eliaskoschke/Der-Geraet/Modelle/BeschriftungsPlatten/Schriftenplatte_Seitlich_1.stl

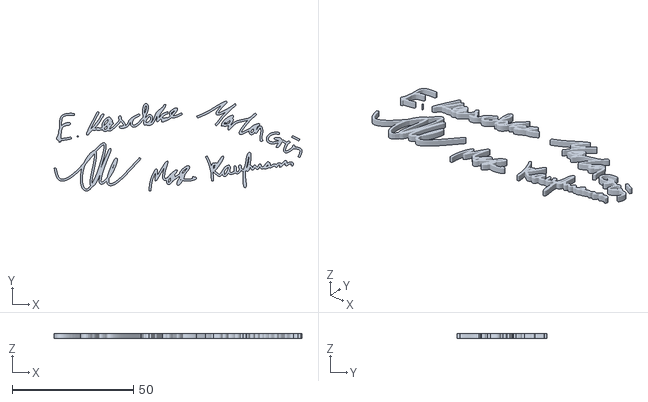
[picture p1: CAD file, 2025-03-31]
Modelle/BeschriftungsPlatten/Schriftenplatte_Seitlich_1.stl
102.1 x 37.2 x 2.00
