eliaskoschke/Der-Geraet/Modelle/MotorRadAdapter.FCStd

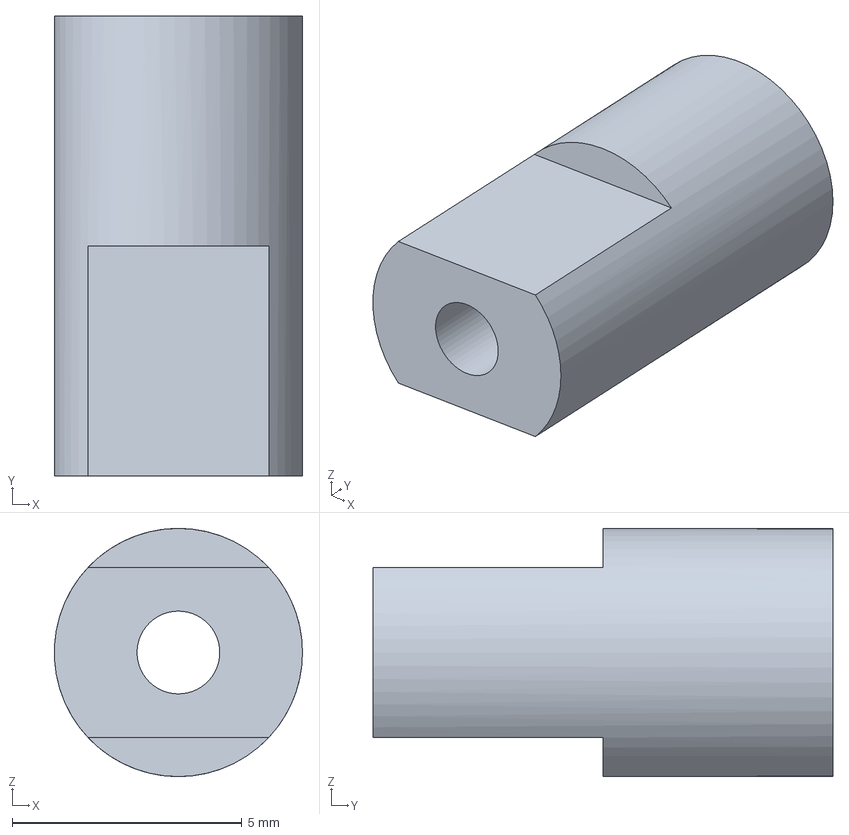
[picture p2: CAD file, 2025-03-31]
Modelle/MotorRadAdapter.FCStd
5.40 x 10.0 x 5.40 mm
