eliaskoschke/Der-Geraet/Modelle/STL/Gehause-Körper.stl

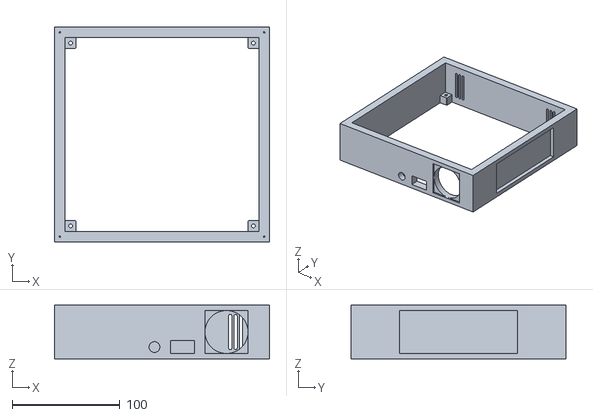
[picture p3: CAD file, 2025-03-31]
Modelle/STL/Gehause-Körper.stl
200.0 x 200.0 x 50.0
