eliaskoschke/Der-Geraet/Modelle/BeschriftungsPlatten/Schriftenplatte_Seitlich_2.stl

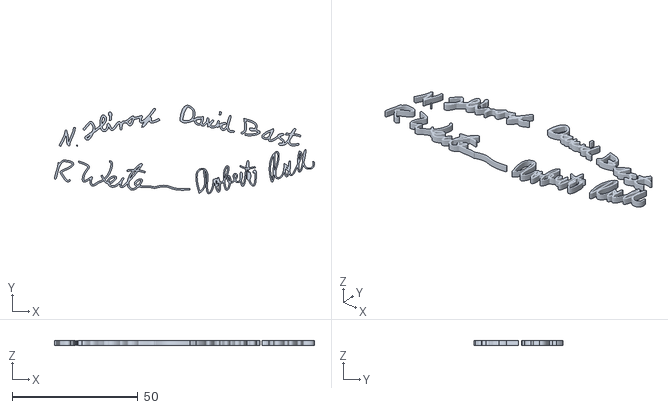
[picture p4: CAD file, 2025-03-31]
Modelle/BeschriftungsPlatten/Schriftenplatte_Seitlich_2.stl
103.3 x 35.2 x 2.00
