eliaskoschke/Der-Geraet/Modelle/Motor-Befestigung-Schraubebefestigung-DerGeraet.FCStd

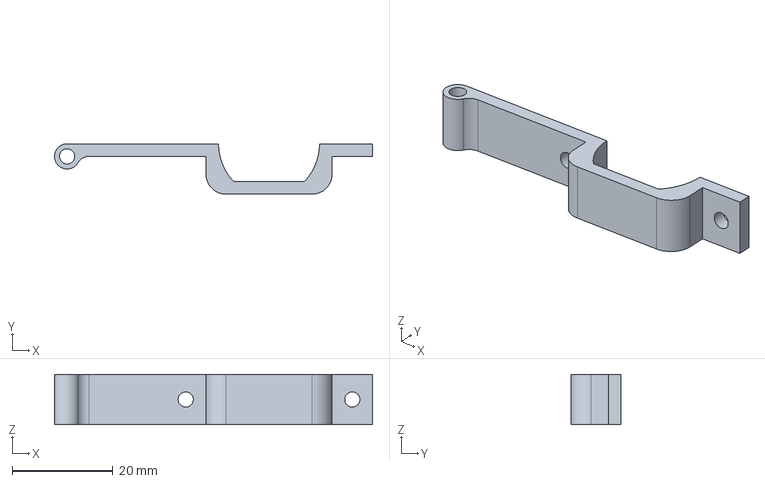
[picture p5: CAD file, 2025-03-31]
Modelle/Motor-Befestigung-Schraubebefestigung-DerGeraet.FCStd
63.0 x 10.0 x 10.0 mm
