eliaskoschke/Der-Geraet/Modelle/STL/Motor-Buegel-DerGeraet-Körper.3mf

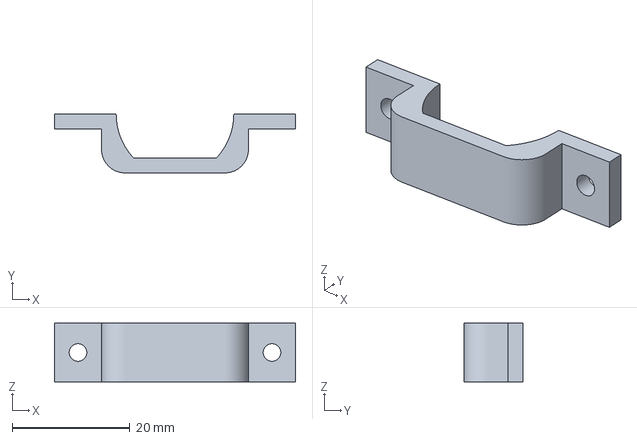
[picture p6: CAD file, 2025-03-31]
Modelle/STL/Motor-Buegel-DerGeraet-Körper.3mf
41.0 x 10.0 x 10.0 mm
