eliaskoschke/Der-Geraet/Modelle/AuswerfRad-DerGeraet.FCStd

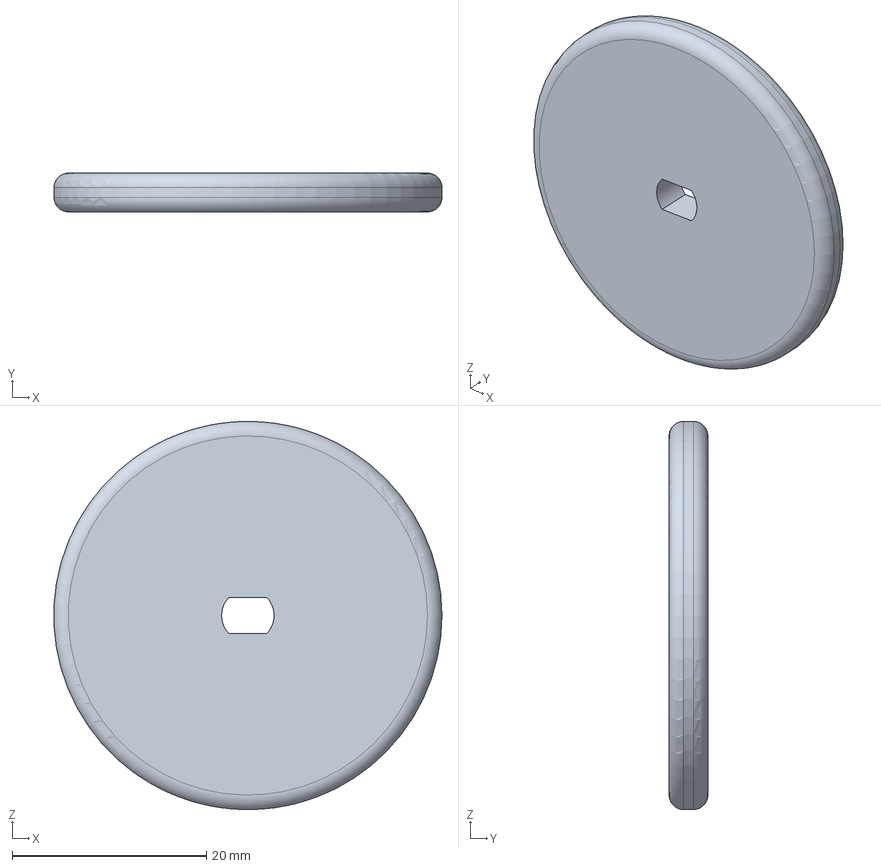
[picture p7: CAD file, 2025-03-31]
Modelle/AuswerfRad-DerGeraet.FCStd
40.0 x 4.00 x 40.0 mm
