eliaskoschke/Der-Geraet/Modelle/BeschriftungsPlatten/Schriftenplatten_STL_verbinden.FCStd

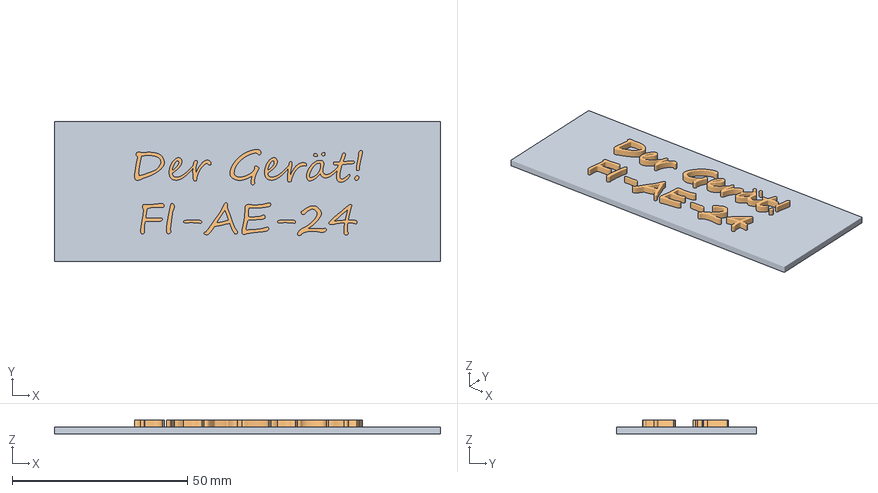
[picture p8: CAD file, 2025-03-31]
Modelle/BeschriftungsPlatten/Schriftenplatten_STL_verbinden.FCStd
110.0 x 40.0 x 3.90 mm
Schriftenplatte_Basis
Schriftenplatte_Frontplatte
