eliaskoschke/Der-Geraet/Modelle/STL/Schriftenplatte_Seitlich_1_mit_Basis.stl

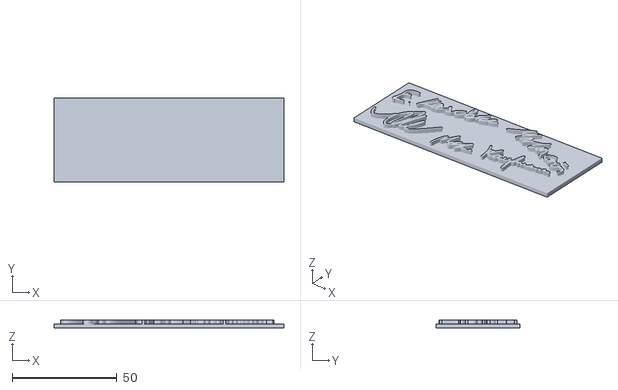
[picture p9: CAD file, 2025-03-31]
Modelle/STL/Schriftenplatte_Seitlich_1_mit_Basis.stl
110.0 x 40.0 x 3.90
