eliaskoschke/Der-Geraet/Modelle/BeschriftungsPlatten/Schriftenplatte_Basis.stl

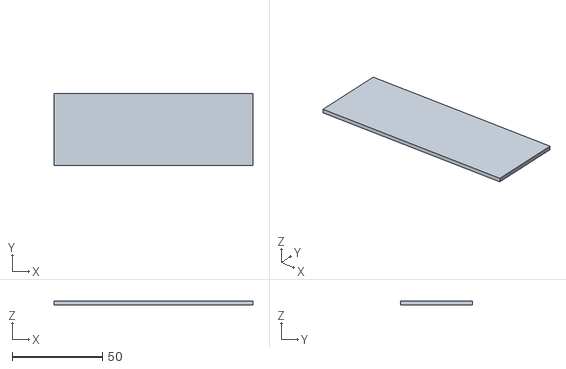
[picture p10: CAD file, 2025-03-31]
Modelle/BeschriftungsPlatten/Schriftenplatte_Basis.stl
110.0 x 40.0 x 2.00
