eliaskoschke/Der-Geraet/Modelle/KeyCap-DerGeraet.FCStd

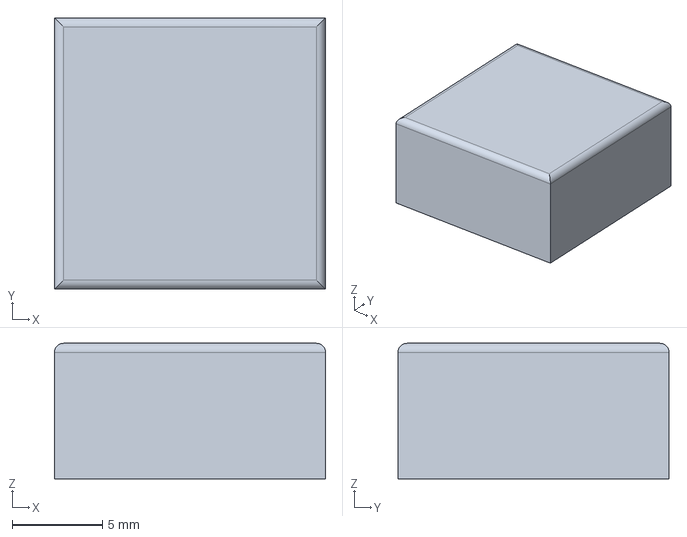
[picture p11: CAD file, 2025-03-31]
Modelle/KeyCap-DerGeraet.FCStd
15.0 x 15.0 x 7.50 mm
