eliaskoschke/Der-Geraet/Modelle/STL/InnenZahnradMitHalterungV5_Grosse_Antrieb.stl

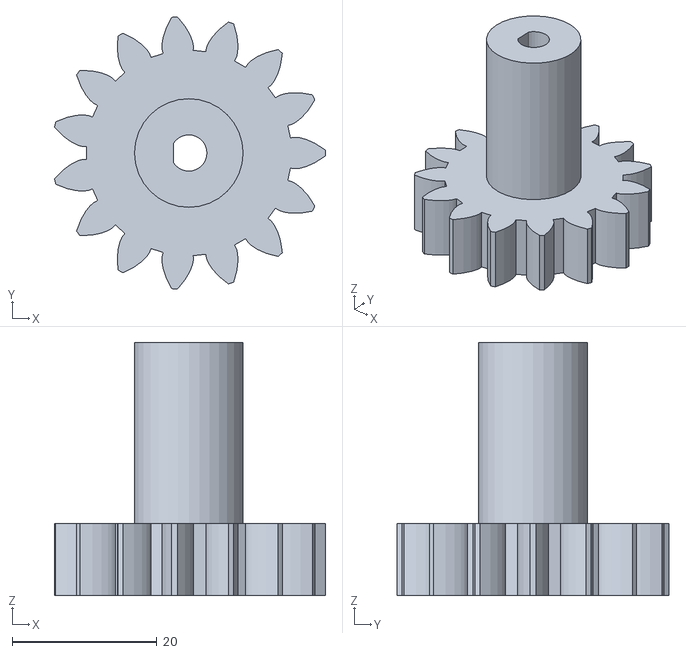
[picture p12: CAD file, 2025-03-31]
Modelle/STL/InnenZahnradMitHalterungV5_Grosse_Antrieb.stl
37.4 x 37.6 x 35.0
