eliaskoschke/Der-Geraet/Modelle/_Zahnrad-vergleich.FCStd

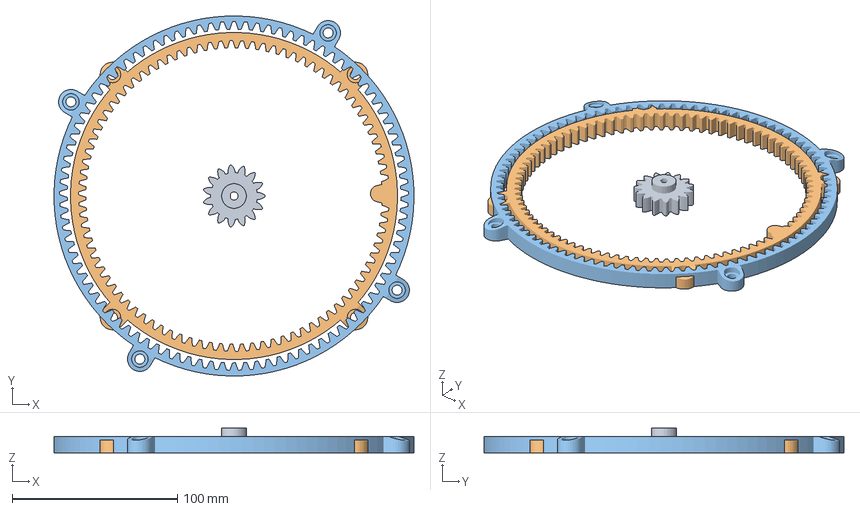
[picture p13: CAD file, 2025-03-31]
Modelle/_Zahnrad-vergleich.FCStd
218.0 x 218.0 x 15.0 mm
InnenZahnradMitHalterungV5_Grosse_Zaehne_Antrieb
InnenZahnradMitHalterungV5_Grosse_Zaehne_Aussen
InnenZahnradMitHalterungV5_Grosse_Zaehne_Aussen001
