eliaskoschke/Der-Geraet/Modelle/Ausweerfmotor-DerGeraet.FCStd

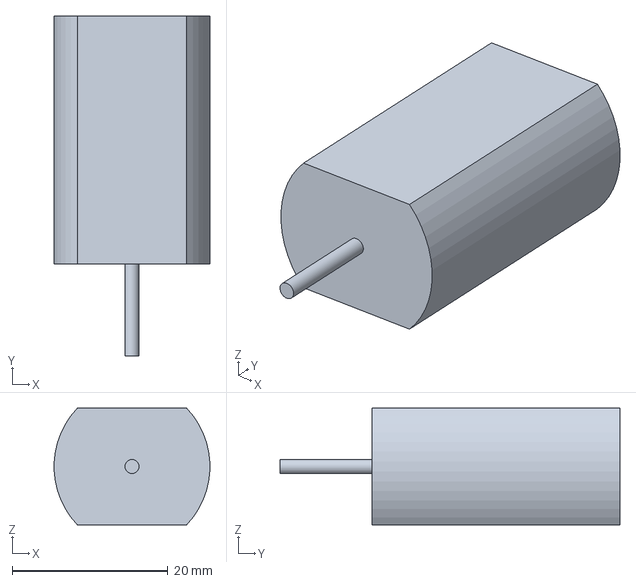
[picture p15: CAD file, 2025-03-31]
Modelle/Ausweerfmotor-DerGeraet.FCStd
20.0 x 43.6 x 15.0 mm
