eliaskoschke/Der-Geraet/Modelle/STL/Geruest-Fuß-links-DerGeraet-Körper.3mf

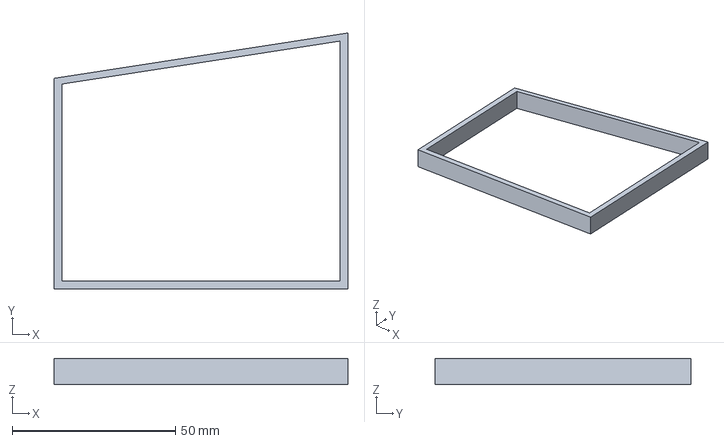
[picture p16: CAD file, 2025-03-31]
Modelle/STL/Geruest-Fuß-links-DerGeraet-Körper.3mf
90.0 x 78.4 x 8.00 mm
