eliaskoschke/Der-Geraet/Modelle/STL/Gerüst-Fuß-Hinten-DerGerät.stl

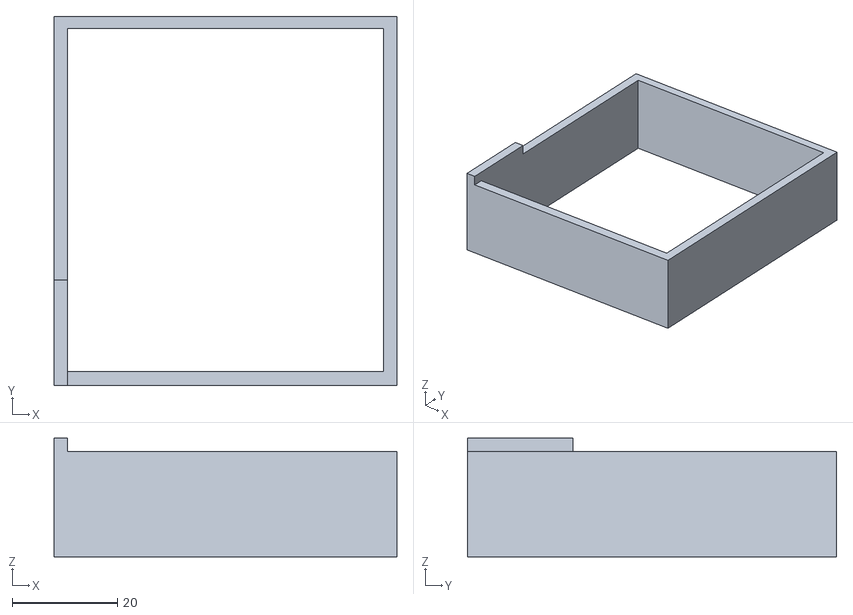
[picture p17: CAD file, 2025-03-31]
Modelle/STL/Gerüst-Fuß-Hinten-DerGerät.stl
65.0 x 70.0 x 22.5
