eliaskoschke/Der-Geraet/Modelle/Geruest-DerGeraet.FCStd

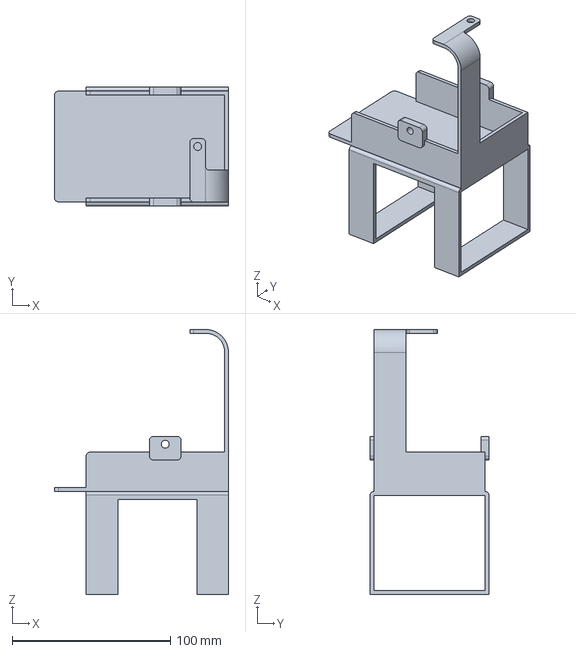
[picture p18: CAD file, 2025-03-31]
Modelle/Geruest-DerGeraet.FCStd
110.0 x 75.0 x 167.5 mm
