eliaskoschke/Der-Geraet/Modelle/STL/Steppermotor-Supportstütze-DerGerät.stl

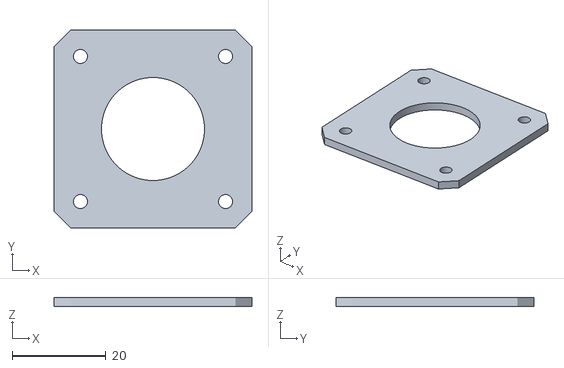
[picture p19: CAD file, 2025-03-31]
Modelle/STL/Steppermotor-Supportstütze-DerGerät.stl
42.3 x 42.3 x 2.00
