eliaskoschke/Der-Geraet/Modelle/Geruest-Fuß-rechts-DerGeraet.FCStd

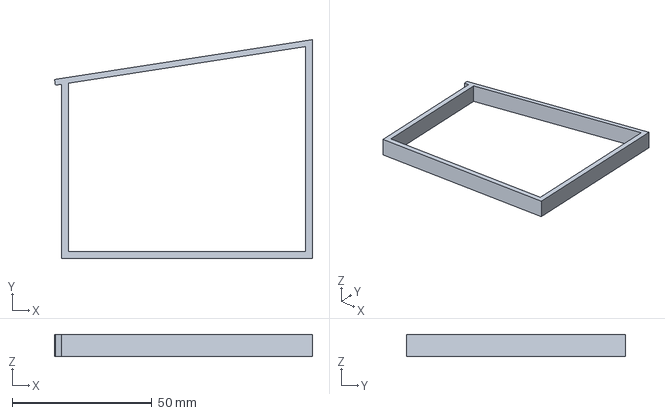
[picture p20: CAD file, 2025-03-31]
Modelle/Geruest-Fuß-rechts-DerGeraet.FCStd
92.5 x 78.4 x 8.00 mm
