eliaskoschke/Der-Geraet/Modelle/STL/Button_03.stl

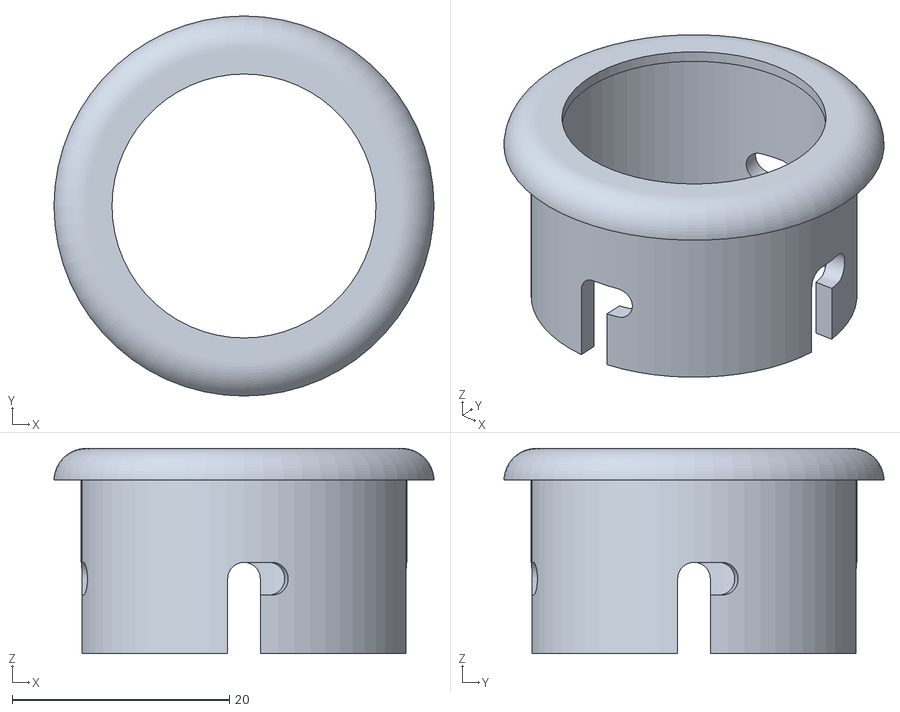
[picture p21: CAD file, 2025-03-31]
Modelle/STL/Button_03.stl
35.0 x 35.0 x 18.9
