eliaskoschke/Der-Geraet/Modelle/Motor-Befestigung-DerGeraet.FCStd

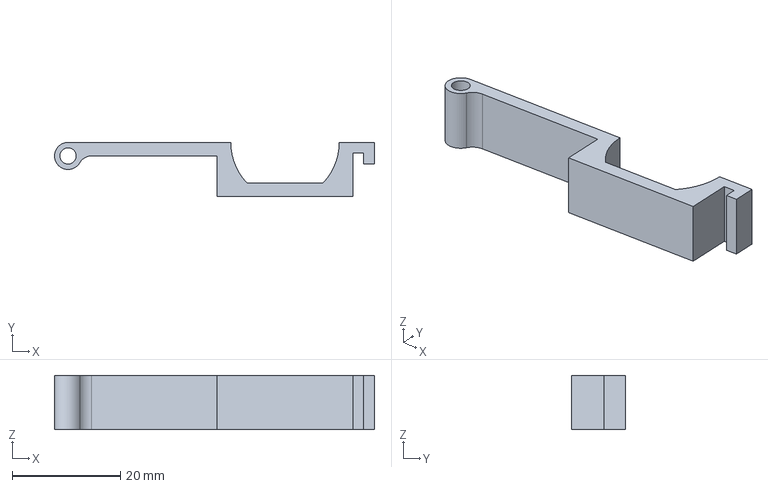
[picture p22: CAD file, 2025-03-31]
Modelle/Motor-Befestigung-DerGeraet.FCStd
59.0 x 10.0 x 10.0 mm
