eliaskoschke/Der-Geraet/Modelle/STL/InnenZahnradMitHalterungV5_Grosse_Zaehne_Aussen.stl

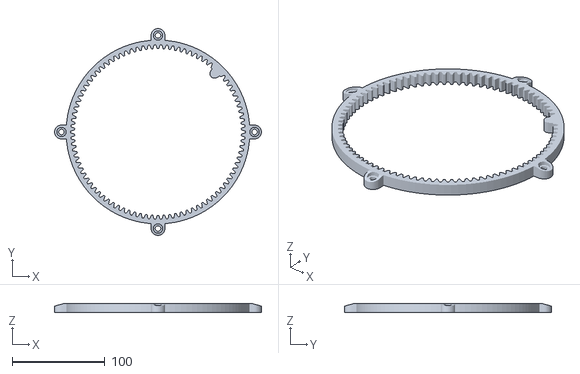
[picture p23: CAD file, 2025-03-31]
Modelle/STL/InnenZahnradMitHalterungV5_Grosse_Zaehne_Aussen.stl
223.0 x 223.0 x 10.0
