eliaskoschke/Der-Geraet/Modelle/Ausweerfmotor-Befestigung.FCStd

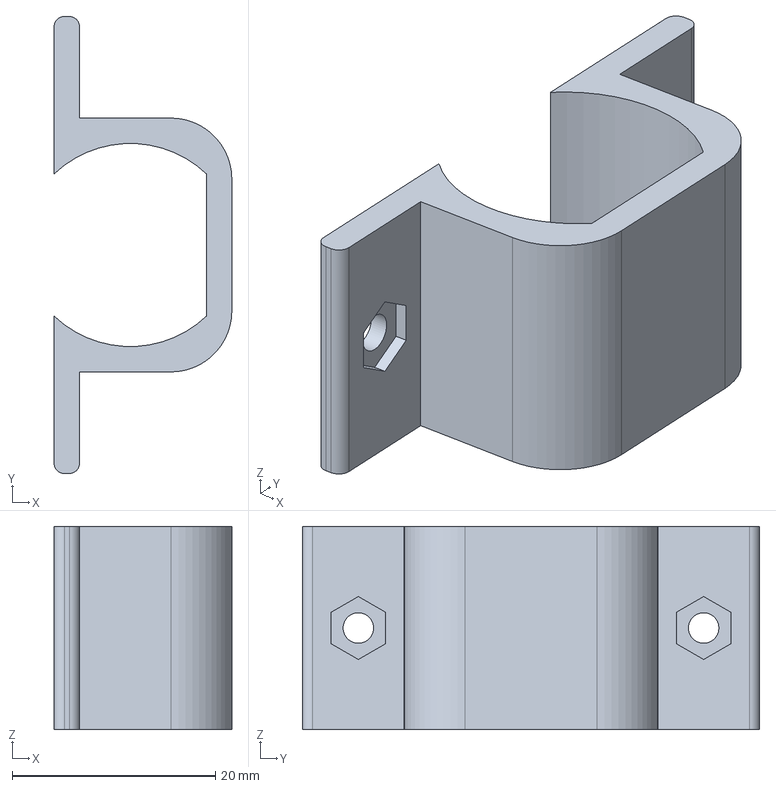
[picture p24: CAD file, 2025-03-31]
Modelle/Ausweerfmotor-Befestigung.FCStd
17.5 x 45.0 x 20.0 mm
