eliaskoschke/Der-Geraet/Modelle/STL/Gerüst-Kartenhalter-DerGerät.stl

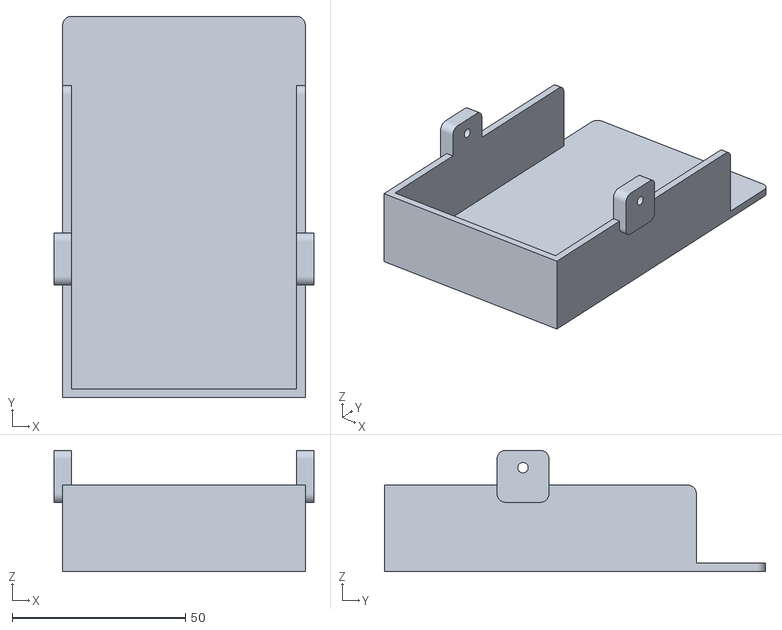
[picture p25: CAD file, 2025-03-31]
Modelle/STL/Gerüst-Kartenhalter-DerGerät.stl
75.0 x 110.0 x 35.0
