eliaskoschke/Der-Geraet/Modelle/Rad-DerGerät.FCStd

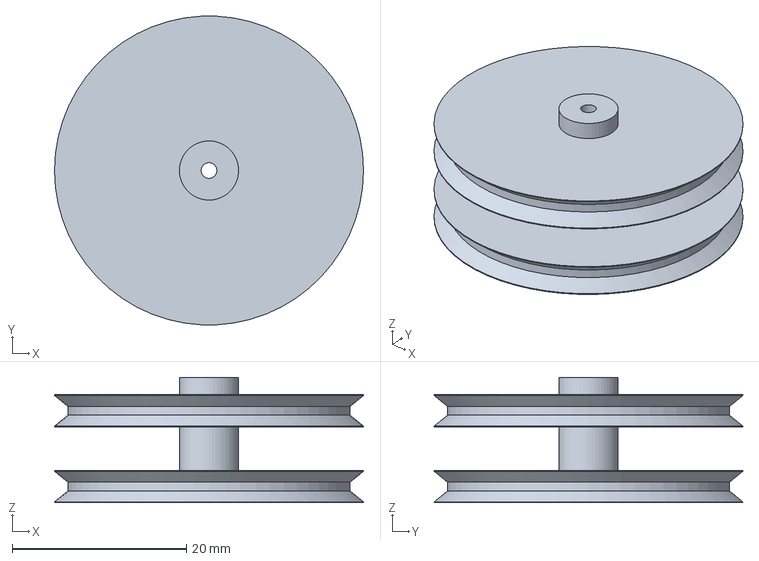
[picture p26: CAD file, 2025-03-31]
Modelle/Rad-DerGerät.FCStd
35.5 x 35.4 x 14.4 mm
