eliaskoschke/Der-Geraet/Modelle/STL/Gerüst-Fuß-Vorne-DerGerät.stl

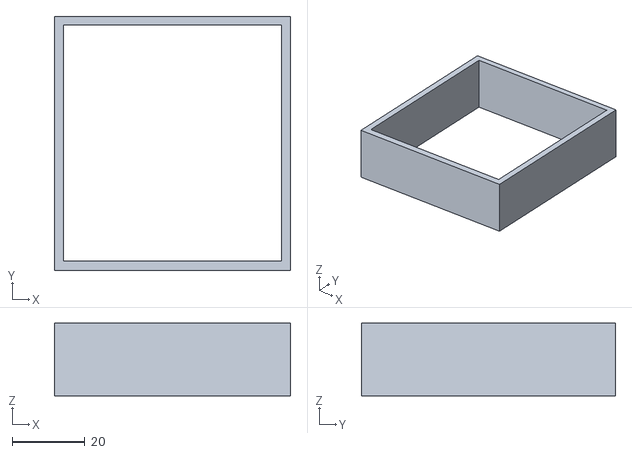
[picture p27: CAD file, 2025-03-31]
Modelle/STL/Gerüst-Fuß-Vorne-DerGerät.stl
65.0 x 70.0 x 20.0
