eliaskoschke/Der-Geraet/Modelle/STL/Gerüst-Kameraständer-DerGerät.stl

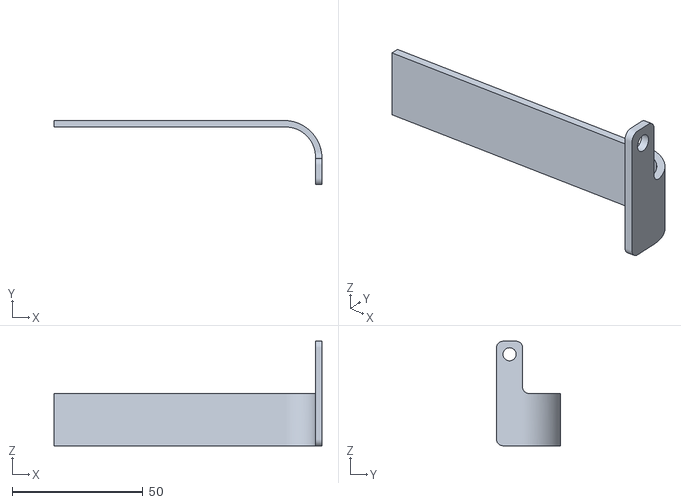
[picture p28: CAD file, 2025-03-31]
Modelle/STL/Gerüst-Kameraständer-DerGerät.stl
102.5 x 24.5 x 40.0
