eliaskoschke/Der-Geraet/Modelle/Geruest-Kameraständer-DerGeraet.FCStd

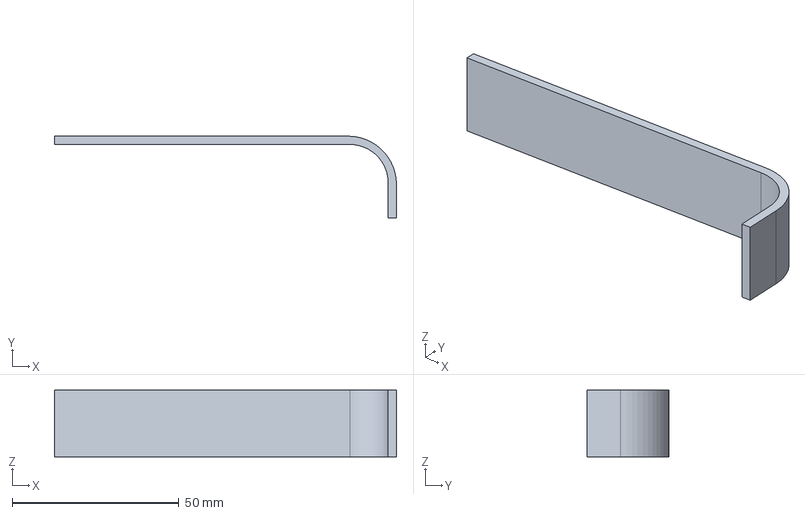
[picture p29: CAD file, 2025-03-31]
Modelle/Geruest-Kameraständer-DerGeraet.FCStd
102.5 x 24.5 x 20.0 mm
