eliaskoschke/Der-Geraet/Modelle/STL/Zahnräder(brauchen_eigentlich_nur_das-Kleine).stl

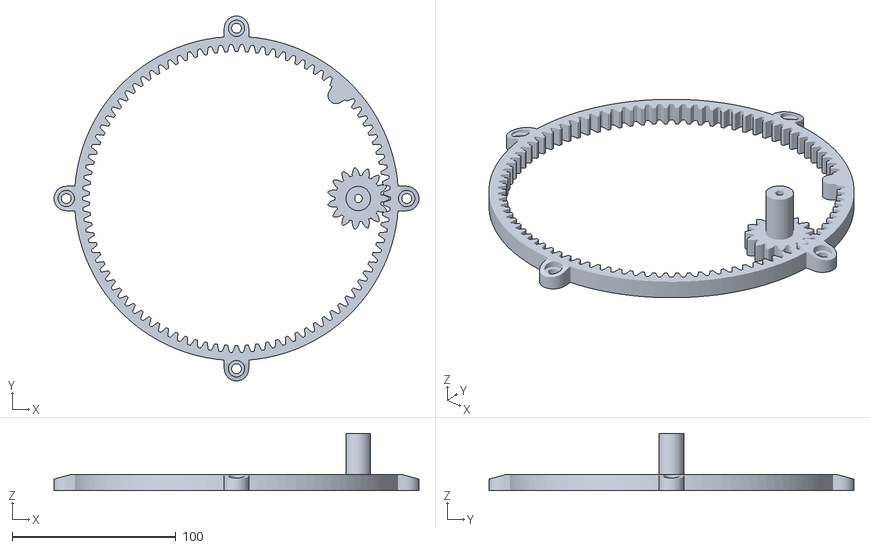
[picture p30: CAD file, 2025-03-31]
Modelle/STL/Zahnräder(brauchen_eigentlich_nur_das-Kleine).stl
223.0 x 223.0 x 35.0
