eliaskoschke/Der-Geraet/Modelle/KameraHalterung-DerGeraet1.FCStd

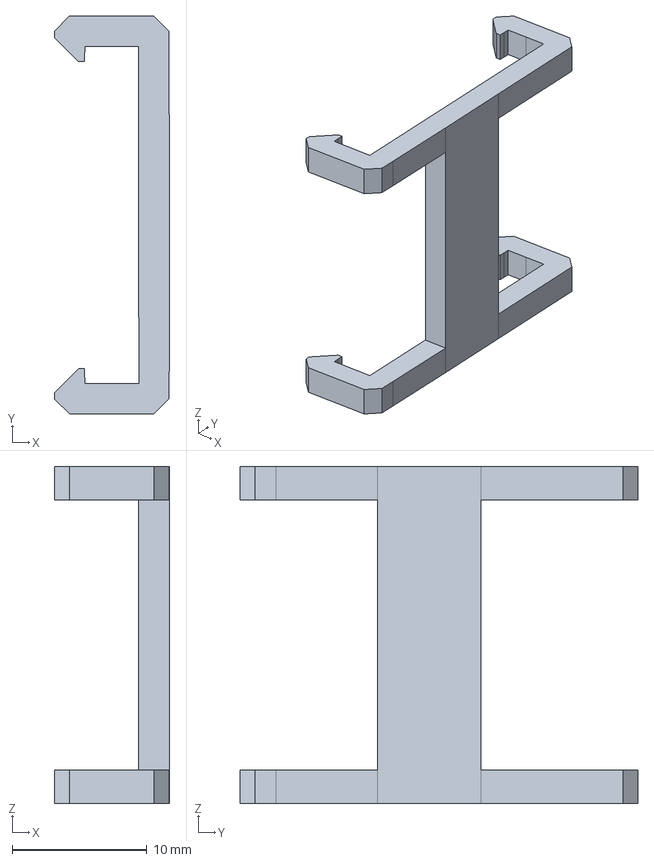
[picture p31: CAD file, 2025-03-31]
Modelle/KameraHalterung-DerGeraet1.FCStd
8.56 x 29.5 x 25.0 mm
