eliaskoschke/Der-Geraet/Modelle/STL/Button_01.stl

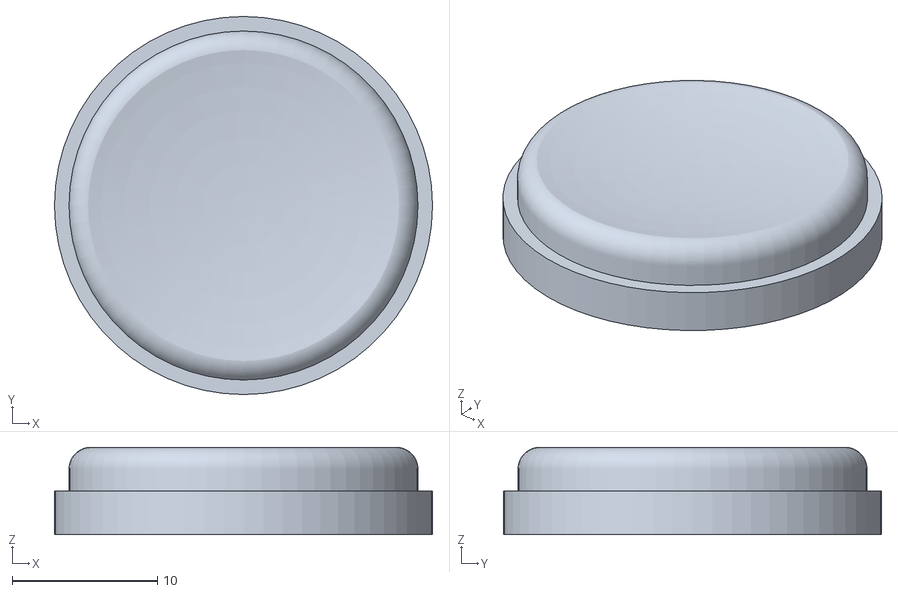
[picture p32: CAD file, 2025-03-31]
Modelle/STL/Button_01.stl
26.0 x 26.0 x 5.99
