eliaskoschke/Der-Geraet/Modelle/Geruest-Kartenhalter-DerGeraet.FCStd

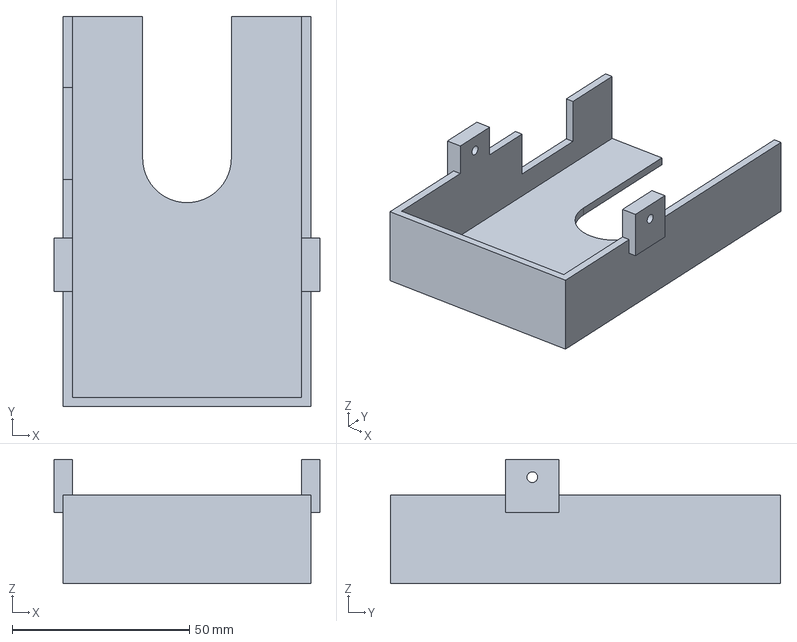
[picture p33: CAD file, 2025-03-31]
Modelle/Geruest-Kartenhalter-DerGeraet.FCStd
75.0 x 110.0 x 35.0 mm
