eliaskoschke/Der-Geraet/Modelle/LuefterGitter.FCStd

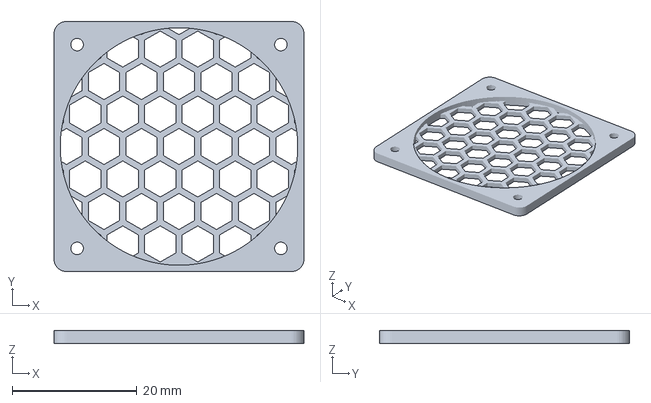
[picture p34: CAD file, 2025-03-31]
Modelle/LuefterGitter.FCStd
40.0 x 40.0 x 2.00 mm
