eliaskoschke/Der-Geraet/Modelle/STL/Button_02.stl

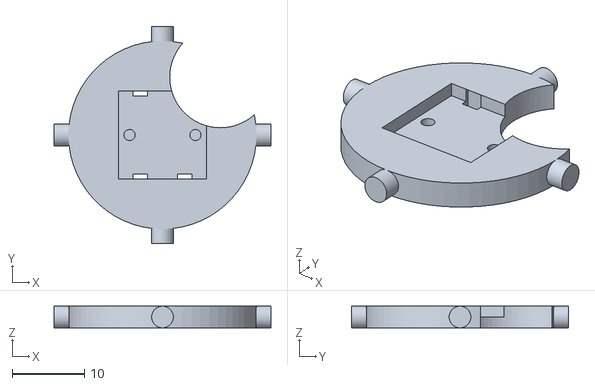
[picture p35: CAD file, 2025-03-31]
Modelle/STL/Button_02.stl
30.0 x 30.0 x 3.00
