eliaskoschke/Der-Geraet/Modelle/STL/MotorStange-DerGerät-Körper.stl

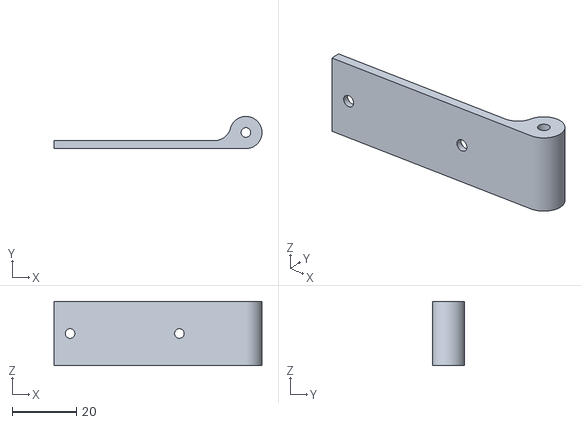
[picture p36: CAD file, 2025-03-31]
Modelle/STL/MotorStange-DerGerät-Körper.stl
64.7 x 10.00 x 20.0
