eliaskoschke/Der-Geraet/(list of files, cad)

Other CAD files:
Modelle/Baugruppe-DerGeraet.FCStd
Modelle/BeschriftungsPlatten/Schriftenplatte_Frontplatte.stl
Modelle/Motor-Buegel-DerGeraet.FCStd
Modelle/Steppermotor-Supportstütze-DerGeraet.FCStd
Modelle/STL/Geruest-Fuß-rechts-DerGeraet-Körper.3mf
Modelle/_GesamtansichtPrototyp.FCStd
Modelle/STL/Motor-Befestigung-Schraubebefestigung-DerGeraet-Körper.3mf
Modelle/Gehause.FCStd
Modelle/STL/Motor-Rad-Adapter-DerGerät.stl
Modelle/Geruest-Fuß-links-DerGeraet.FCStd
Modelle/STL/Ausweerfmotor-DerGeraet-Körper001.3mf
Modelle/STL/Schriftenplatte_Frontplatte_mit_Basis.stl
Modelle/STL/Rad-DerGerät-Körper.stl
Modelle/Rad-DerGeraet.FCStd
Modelle/STL/Geruest-Kameraständer-DerGeraet-Körper.3mf
Modelle/STL/KameraHalterung-DerGerät.stl
Modelle/STL/Geruest-Kartenhalter-DerGeraet-Körper.3mf
Modelle/Archiv/Stange-DerGeraet.FCStd
Modelle/STL/Ausweerfmotor-Befestigung.stl
Modelle/STL/LuefterGitter.stl
