eliaskoschke/Der-Geraet/src/main/java/com/example/tcm2209/StepperController.java

package com.example.tcm2209;

import com.pi4j.context.Context;
import com.example.tcm2209.TMCCommunicationException;
import com.example.tcm2209.TMCDeviceIsBusyException;
import com.example.tcm2209.Tmc2209;

public class StepperController {
    private static final int PIN_INDEX = 23;
    private static final int PIN_STEP = 18;
    private static final int PIN_DIR = 24;
    private static final int SPEED = 1200;
    private static final int HOMESPEED = 1000;
    private static final int TRESHOLD = 58;
    Tmc2209 steppermotor;

    Context pi4j;

    public StepperController(Context pi4j) {
        try {
            this.pi4j = pi4j;
            steppermotor = new Tmc2209(pi4j, PIN_INDEX, PIN_DIR, PIN_STEP);
        } catch( Exception e){
            e.printStackTrace();
        }
    }

    public void orientieren() throws TMCDeviceIsBusyException {
        steppermotor.homePosition(HOMESPEED,TRESHOLD);
    }

    public void turn(int grad) throws TMCDeviceIsBusyException {
        steppermotor.moveToPosition(calc(grad),SPEED);
    }

    /**
     * Rechnung:
     * 8: treiber hat pro Grad des Steppers 8 Schritte
     * 1.8: Grad pro schritt
     * 6: Verhältnis von großem zu kleinem Rad
     * @param grad des Gerätes zu der es soll
     * @return umgerechnte Schritte des Motors
     */
    private int calc(int grad) {
        int result = (int) ((grad * 8) /(1.8 / 6 ));//TODO: Testen ob statt 6 doch 2.6 verwendet werden muss
        return result;
    }
}
