eliaskoschke/Der-Geraet/(commit log)

2025-02-13 Reset Funktion für Rückgabewerte wurde eingefügt
    [Controller.java]
2025-02-19 Button click an Web angepasst, damit es endlich funktioniert
2025-02-19 Test um LED anzusteuern
2025-02-19 Button Klick LED Test hat geklappt
2025-02-19 ButtonClickedTwice wurde hinzugefügt
2025-02-20 Timer zum Bilder testen hinzugefügt
2025-02-20 Discard Motor wurde hinzugefügt
2025-02-20 Motoren pins wurden angepasst
2025-02-20 bilder und leichte aenderungen
2025-02-20 Karten auf der Website werden jetzt auch verdeckt angezeigt
2025-02-21 Kamera per Knopdruck ansteuern ist jetzt möglich und auch, dass es ein Karten Objekt erstellt
2025-02-21 Behebung, dass Karte "wert" ein Integer ist und kein string
2025-02-21 fehler behoben (Controller) Anpassungen website
    [Controller.java]
2025-02-21 Gerüst in einzelteile zerlegt
    [Gerüst-Fuß-Hinten-DerGerät.FCStd, Gerüst-Fuß-Vorne-DerGerät.FCStd, Gerüst-Kameraständer-DerGerät.FCStd, Gerüst-Kartenhalter-DerGerät.FCStd]
2025-02-21 -Bug Fixes -MErge Conflikt Probleme wurden hoffentlich behoben
    [Controller.java, GameService.java, Main.java]
2025-02-24 Regedtrieren der Spieler klappt einigermasen aber mann muss beides ungefähr gleichzeitig starten
2025-02-24 Zahnrad STL Aussen und Antrieb separat
    [InnenZahnradMitHalterungV5_Grosse_Zaehne_Antrieb.stl, InnenZahnradMitHalterungV5_Grosse_Zaehne_Aussen.stl]
2025-02-25 Mapping Klasse für die button und button Freigabe. Button High Un dLow setzen wird jetzt in der RaspberryController Klasse gemacht.
2025-02-27 Docu Getriebe und V5 incl. aktueller STL hochgeladen.
    [InnenZahnradMitHalterungV5_Grosse_Zaehne.stl, InnenZahnradMitHalterungV5_Grosse_Zaehne_Antrieb.stl, InnenZahnradMitHalterungV5_Grosse_Zaehne_Aussen.stl, Zahlräder-DerGerät.scad]
2025-03-04 Einzel und Doppelklick funktionieren
2025-03-04 Lueftergitte ergänzt - Gesamtansicht prototyp
    [LuefterGitter.FCStd, LuefterGitter.stl, MontageTestdie321654316463.FCStd, _GesamtansichtPrototyp.FCStd, _Zahnrad-vergleich.FCStd]
2025-03-04 Lueftergitter flach liegend
    [LuefterGitter.FCStd, LuefterGitter.stl]
2025-03-05 Erster Versuch eines Reset und Restart Buttons
    [GameService.java, Main.java]
2025-03-05 Verstärkungszylinder wurde auf 25mm abgeändert
    [Zahlräder-DerGerät.scad]
2025-03-06 wird eh nicht klappen
2025-03-06 MotorController sind im Main
2025-03-06 Hoffentlich Fixed es das wieder
    [Controller.java, GameService.java, Main.java]
2025-03-07 fehlerbehebung js dass section nicht in der sitzauswahl angezeigt wird
2025-03-07 Stepper Motor Klappt mit Positionen
2025-03-10 Auswurf Motor wurde hinzugefügt
2025-03-13 Website Fix versuch 1
    [Controller.java, Main.java]
2025-03-13 Website Fix versuch 2
    [Controller.java]
2025-03-13 settings-html und admin-html winner eingefügt
2025-03-13 Website Fix versuch 3
    [Controller.java, Main.java]
2025-03-13 Website Fix versuch 4
    [KartenMotor.java, Main.java]
2025-03-13 current player gefixt?
2025-03-13 dealerhand und currentplayer in admin gefixt?
2025-03-13 dealerhand und spieleranzahl gefixt (hoffentlich)
2025-03-13 ping und admin.html das mysterium trailer 1
2025-03-13 Website Fix versuch 5
    [Controller.java, Main.java]
2025-03-13 Website Fix versuch 6
    [Controller.java]
2025-03-13 Website Fix versuch 7
    [Controller.java, GameService.java, Main.java]
2025-03-13 Überarbeitung der 3D-Modelle Gehäuse gabaut Motorbefestigung geändert Füßse angeschrägt KeyCaps erstellt Kartenhalter verbessert typo
    [Gehause.FCStd, Gerüst-Fuß-Hinten-DerGerät.FCStd, Gerüst-Fuß-Vorne-DerGerät.FCStd, Gerüst-Fuß-links-DerGerät.FCStd, Gerüst-Fuß-rechts-DerGerät.FCStd, Gerüst-Kameraständer-DerGerät.FCStd, Gerüst-Kartenhalter-DerGerät.FCStd, KeyCap-DerGerät.FCStd]
2025-03-14 Überarbeutung von Füß: Kamerastütze berichtigt Auswerfmotorbefestigung abgeändert, dass durch schrauben möglich ist.
    [Ausweerfmotor-Befestigung.FCStd, Motor-Befestigung-Schraubebefestigung-DerGerät.FCStd, Motor-Buegel-DerGerät.FCStd]
2025-03-14 Gehäuse hat vertiefungen für unterschriftsplatten bekommen
    [Gehause.FCStd]
2025-03-14 DoppelRad hinzugefügt
    [Rad-DerGerät.FCStd]
2025-03-17 Button für Tisch wurde hinzugefügt
    [Button_01.stl, Button_02.stl, Button_03.stl]
2025-03-18 css play und startseite
2025-03-18 adminpage button lock fixed
2025-03-20 Beschissenes Button Layout gefixt
2025-03-27 test ob beenden button klappt
2025-03-28 Beschriftungsplatten ergänzt.
    [Halterung.scad, Schriften.scad, Schriftenplatte_Basis.stl, Schriftenplatte_Frontplatte.stl, Schriftenplatte_Frontplatte_mit_Basis.stl, Schriftenplatte_Seitlich_1.stl, Schriftenplatte_Seitlich_1_mit_Basis.stl, Schriftenplatte_Seitlich_2.stl]
2025-03-28 Gehäuse als STL ergänzt.
    [Gehause-Körper.stl, MotorStange-DerGeraet.stl, Stange-DerGeraet.FCStd]
2025-03-28 Doppeltrad ergänzt.
    [Rad-DerGerät-Körper.stl]
2025-03-28 Button OpenSCAD Datei hinzugefügt
    [Button.scad]
2025-03-28 - Frontschriftplatte vereinfacht. (zu fein für 3D Druckdüse grob) - 3MF / STL generiert.
    [Ausweerfmotor-DerGeraet-Körper001.3mf, Geruest-Fuß-links-DerGeraet-Körper.3mf, Geruest-Fuß-rechts-DerGeraet-Körper.3mf, Geruest-Kameraständer-DerGeraet-Körper.3mf, Geruest-Kartenhalter-DerGeraet-Körper.3mf, Motor-Befestigung-Schraubebefestigung-DerGeraet-Körper.3mf, Motor-Buegel-DerGeraet-Körper.3mf, Schriftenplatte_Frontplatte.stl]
2025-03-28 dateien verschoben
    [Ausweerfmotor-Befestigung.FCStd, Ausweerfmotor-Befestigung.stl, Ausweerfmotor-DerGeraet-Körper001.3mf, Ausweerfmotor-DerGeraet.FCStd, AuswerfRad-DerGeraet.FCStd, Baugruppe-DerGeraet.FCStd, Button.scad, Button_01.stl]
